RolandWukovits/AC-Powerwall/AC-Powerwall.pdf

## Charger 1

20A

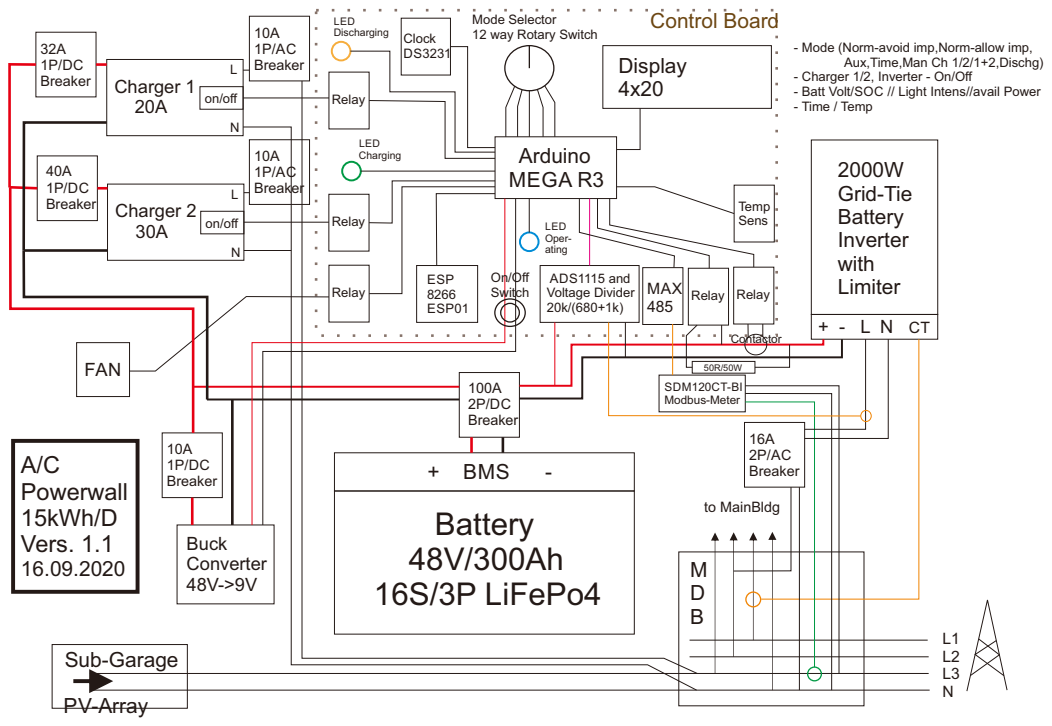
[picture p72: page 1]
Charger 2 30A; on/off; Battery 48V/300Ah 16S/3P LiFePo4; BMS; 2000W Grid-Tie Battery Inverter with Limiter; FAN; Buck Converter 48V->9V; 100A 2P/DC Breaker; 32A 1P/DC Breaker; 10A 1P/DC Breaker; 16A 2P/AC Breaker; 10A 1P/AC Breaker; 40A 1P/DC Breaker; to MainBldg; SDM120CT-BI Modbus-Meter; Sub-Garage; Arduino MEGA R3; MAX 485; Relay; Relay Relay; Clock DS3231; ESP 8266 ESP01; ADS1115 and Voltage Divider 20k/(680+1k); Temp Sens; LED Charging; LED Oper- ating; LED Discharging; Display 4x20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

Mode Selector
12 way Rotary Switch

- Mode (Norm-avoid imp,Norm-allow imp,

Aux,Time,Man Ch 1/2/1+2,Dischg)

- Charger 1/2, Inverter - On/Off
- Batt Volt/SOC // Light Intens//avail Power
- Time / Temp
