RolandWukovits/AC-Powerwall/(commit log)

2020-12-15 Update and rename AC-PowerwallOLED.ino to AC-Powerwall.ino
2021-06-24 Update and rename AC-Powerwall_V3plus.ino to AC-Powerwall_V3.ino
